Maleksameh61/Agribot/AgriBot_PCB_Cost.csv

Item | Location | Part | Qty | Unit (USD) | Total (USD) | Link | Shop (Egypt) | Product name | Unit (EGP) | Total (EGP) | Notes | International (AliExpress) | International note
1 | On the PCB | ESP32 DevKit 30-pin (CP2102) - Motion, Sensors, Audio | 3 | 5.303 | 15.91 | https://makerselectronics.com/product/esp32-development-board/ | Makers Electronics | ESP32 Development Board WIFI and Bluetooth 30-Pin with CP2102 | 280.0 | 840.0 | In stock. Measure the row gap before soldering sockets | https://www.aliexpress.com/item/1005005692090880.html | Pick the CP2102 MICRO 30Pin option. Rows must be 25.4 mm (1 in) apart to fit the footprint, many 30-pin boards are 22.86 mm
2 | On the PCB | LM2596S-ADJ buck module | 5 | 1.042 | 5.21 | https://microohm-eg.com/lm2596s-dc-step-down-3a/ | Micro Ohm | LM2596S-ADJ DC-DC Buck Converter 3A | 55.0 | 275.0 | Makers has it for 35 but sold out | https://www.aliexpress.com/item/10000000656280.html | Adjustable one with the trimmer, not fixed 5V. SIM800L needs 4.0V
3 | On the PCB | DRV8825 stepper driver | 1 | 1.515 | 1.52 | https://microohm-eg.com/drv8825-stepper-motor-driver-heatsink/ | Micro Ohm | DRV8825 Stepper Motor Driver with Aluminum Heat Sink | 80.0 | 80.0 | Only local source found | https://www.aliexpress.com/item/32852539255.html | Pololu-style 16-pin, with heatsink
4 | On the PCB | SIM800L GSM module + antenna | 1 | 5.492 | 5.49 | https://microohm-eg.com/sim800l-gprs-gsm-module-core-board-quad-band-ttl-serial-port-with-the-antenna/ | Micro Ohm | SIM800L GPRS GSM Module Core Board Quad-band with antenna | 290.0 | 290.0 | Backup: Makers ESP-style board 400, in stock. Check pinout matches the footprint | https://www.aliexpress.com/item/1005008338130781.html | 2G only. Check your country still has a 2G network. Check pin order matches the footprint
5 | On the PCB | MAX98357A I2S amp | 2 | 2.841 | 5.68 | https://microohm-eg.com/max98357a-mod/ | Micro Ohm | MAX98357A I2S 3W Class D Amplifier Module | 150.0 | 300.0 | In stock. Makers 120 but sold out | https://www.aliexpress.com/item/1005006264217290.html | 7-pin module (with GAIN and SD)
6 | Plugs in by cable | MicroSD card module | 1 | 0.758 | 0.76 | https://makerselectronics.com/product/micro-sd-card-reader-module/ | Makers Electronics | Micro SD Card Reader Module | 40.0 | 40.0 | Check it has the level shifter (fed from 5V on this board) | https://www.aliexpress.com/i/2251801679301703.html | Must have the regulator and level shifter, it gets 5V
7 | On the PCB | TTL to RS485 auto-direction module | 1 | 1.515 | 1.52 | https://makerselectronics.com/product/hw-519-ttl-to-rs485-converter-module/ | Makers Electronics | HW-519 TTL to RS485 Converter Module | 80.0 | 80.0 | Stock not shown. Backup Micro Ohm 90 (out of stock) | https://www.aliexpress.com/item/1005010426401155.html | HW-519. Must be auto-direction, 4 logic pins, no DE/RE
8 | On the PCB | MPU6050 (GY-521) | 1 | 1.894 | 1.89 | https://makerselectronics.com/product/mpu-6050-imu-sensor-module-with-6-dof-gyroscope-accelerometer/ | Makers Electronics | MPU-6050 IMU Sensor Module 6 DOF | 100.0 | 100.0 | Backup Micro Ohm 125 | https://www.aliexpress.com/item/32340949017.html | GY-521
9 | On the PCB | BH1750 (GY-302) | 1 | 4.735 | 4.73 | https://microohm-eg.com/gy-302-bh1750-light-intensity-module/ | Micro Ohm | GY-302 BH1750 Light Intensity Module | 250.0 | 250.0 | Future has it for 120 but sold out | https://www.aliexpress.com/item/32341898423.html | GY-302
10 | Plugs in by cable | AHT20 + BMP280 module | 1 | 4.167 | 4.17 | https://microohm-eg.com/aht20bmp280-temperature-humidity-and-air-pressure-module/ | Micro Ohm | AHT20+BMP280 Temperature Humidity and Air Pressure Module | 220.0 | 220.0 | Only local combo found | https://www.aliexpress.com/item/1005007868094906.html
11 | Plugs in by cable | NEO-6M GPS + antenna | 1 | 8.333 | 8.33 | https://microohm-eg.com/ublox-gps-module-gy-neo6mv2-w-eprom-antena-u-blox/ | Micro Ohm | Ublox GPS Module GY-NEO6M with EEPROM + Antenna | 440.0 | 440.0 | Backup Makers 565, in stock | https://www.aliexpress.com/item/1005006523594418.html | Pick the one with the antenna
12 | Plugs in by cable | HC-SR04 ultrasonic | 2 | 0.758 | 1.52 | https://microohm-eg.com/hc-sr04-ultrasonic-range-finder/ | Micro Ohm | HC-SR04 Ultrasonic Range Finder Sensor | 40.0 | 80.0 |  | https://www.aliexpress.com/item/4000124226294.html
13 | On the PCB | XT60 male+female pair | 2 | 0.568 | 1.14 | https://microohm-eg.com/product/amass-nylon-xt60-connectors-male-female-pair/ | Micro Ohm | Amass Nylon XT60 Connectors Male/Female Pair | 30.0 | 60.0 | Sold out at Makers, Future and Free Electronics. Call Micro Ohm first | https://www.aliexpress.com/item/1005001279983590.html | Amass XT60H, 5 pairs. Real Amass, fakes are softer plastic and up to 20A goes through
14 | On the PCB | 5x20 fuse clips (pair) | 3 | 0.028 | 0.09 | https://makerselectronics.com/product/fuse-holder-on-pcb-for-t5x20-size-pa/ | Makers Electronics | Fuse Holder on PCB for T5x20 Size (Pair) | 1.5 | 4.5 | In stock | https://www.aliexpress.com/item/1005009806807333.html | Pick 5x20 Clip, 20pcs. 2 clips per fuse
15 | On the PCB | Fuse 20A 5x20 ceramic | 2 | 0.047 | 0.09 | https://makerselectronics.com/product/ceramic-fuse-20a-250v-size-t5x20mm/ | Makers Electronics | Ceramic Fuse 20A 250V T5x20mm | 2.5 | 5.0 | Buy 4, keep spares | https://www.aliexpress.com/item/1005005744701067.html | Pick T20AH250V. Ceramic, not glass
16 | On the PCB | Fuse 5A 5x20 slow-blow | 1 | 0.028 | 0.03 | https://makerselectronics.com/product/ceramic-fuse-5a-250v-size-t5x20mm/ | Makers Electronics | Ceramic Fuse 5A 250V T5x20mm | 1.5 | 1.5 | Out of stock everywhere online, check in person | https://www.aliexpress.com/item/1005005744701067.html | Same listing as the 20A, pick T5AH250V (slow-blow)
17 | On the PCB | MBR4045CT Schottky | 1 | 0.852 | 0.85 | https://makerselectronics.com/product/mbr4045ct-schottky-rectifier-diode-4/ | Makers Electronics | MBR4045CT Schottky Rectifier Diode 45V 40A TO-220AB | 45.0 | 45.0 | In stock | https://www.aliexpress.com/item/1005006070897032.html | TO-220
18 | On the PCB | Screw terminal 2-pin 7.5mm (motor driver power out) | 2 | 0.123 | 0.25 | https://makerselectronics.com/product/terminal-block-2-pin-kf128-7-5-2p-7/ | Makers Electronics | Terminal Block 2 Pin KF128-7.5-2P | 6.5 | 13.0 | In stock | https://www.aliexpress.com/item/1005005966834427.html | Pick KF128-7.5-2P
19 | On the PCB | Screw terminal 3-pin 5mm (soil probe power) | 1 | 0.095 | 0.09 | https://makerselectronics.com/product/kf127-5-0-3p-green-terminal-block/ | Makers Electronics | KF127-5.0-3P Green Terminal Block | 5.0 | 5.0 | 5.0 mm pitch, footprint is 5.08. Fits | https://www.aliexpress.com/item/1005005966834427.html | Same listing as the 7.5mm one, pick KF127-5.0-3P
20 | On the PCB | Screw terminal 2-pin 5mm | 1 | 0.076 | 0.08 | https://makerselectronics.com/product/kf128-5-2p-green-terminal-block-300v/ | Makers Electronics | KF128-5-2P Green Terminal Block | 4.0 | 4.0 |  | https://www.aliexpress.com/item/32988969394.html | KF128-5.0-2P
21 | On the PCB | JST XH 4-pin board header | 7 | 0.011 | 0.08 | https://makerselectronics.com/product/b4b-xh-a-jst-xh-4-pin-header-2-5mm/ | Makers Electronics | B4B-XH-A JST XH Male 4 Pin Header 2.5mm | 0.6 | 4.2 |  | https://www.aliexpress.com/item/33011012548.html | Pick 4P
22 | On the PCB | JST XH 5-pin board header | 3 | 0.014 | 0.04 | https://makerselectronics.com/product/b5b-xh-a-jst-xh-5-pin-header-2-5mm/ | Makers Electronics | B5B-XH-A JST XH Male 5 Pin Header 2.5mm | 0.75 | 2.25 |  | https://www.aliexpress.com/item/33011012548.html | Same listing as the 4-pin, pick 5P
23 | Cables | JST XH 4-pin pre-wired lead | 7 | 0.208 | 1.46 | https://makerselectronics.com/product/data-cable-jst-4-pin-2-54mm-25cm-one-side-terminal | Makers Electronics | Data Cable JST 4 Pin 25cm one side | 11.0 | 77.0 | No shop sells bare XH housings + crimps | https://www.aliexpress.com/item/1005005570841743.html | Pick 4P, female, single head (one end pre-wired)
24 | Cables | JST XH 5-pin pre-wired lead | 3 | 0.161 | 0.48 | https://microohm-eg.com/product/jst-xh-2-54-5-pin-connector-set-wire/ | Micro Ohm | JST XH 5 Pin single-end female 20cm | 8.5 | 25.5 | Stock unclear | https://www.aliexpress.com/item/1005005570841743.html | Same listing as the 4-pin, pick 5P, female, single head
25 | On the PCB | Female header strip 1x40 | 6 | 0.095 | 0.57 | https://makerselectronics.com/product/pin-headers-female-2-54mm-40-pin/ | Makers Electronics | Pin Headers Female 2.54mm 40-Pin | 5.0 | 30.0 | For ESP32s, amps, DRV8825, SIM800L, IMU, microSD, spares | https://www.aliexpress.com/item/1005001621924231.html | 1x40, 2.54 mm
26 | On the PCB | Male header strip 1x40 | 1 | 0.057 | 0.06 | https://makerselectronics.com/product/pin-headers-male-2-54mm-40-pin-strai/ | Makers Electronics | Pin Headers Male 2.54mm 40-Pin | 3.0 | 3.0 | Gain jumpers + servo headers | https://www.aliexpress.com/item/32823083016.html | 1x40, 2.54 mm
27 | On the PCB | Jumper caps | 2 | 0.095 | 0.19 | https://makerselectronics.com/product/jumper-shunt-2-pin-2-54mm-5-pcs/ | Makers Electronics | Jumper Shunt 2 Pin 2.54mm (5 pcs) | 5.0 | 10.0 | ESTIMATE, price not listed online (a few EGP per pack of 5) | https://www.aliexpress.com/item/1005008466863615.html | 2.54 mm
28 | On the PCB | LED 5mm | 5 | 0.009 | 0.05 | https://free-electronic.com/product/led-red-color-5mm/ | Free Electronics | LED Red Color (5mm) | 0.5 | 2.5 | One per power rail | https://www.aliexpress.com/item/4000412956904.html | Pick Red-Red
29 | On the PCB | Resistors 1/4W (220 x5, 1k x3, 2k x2, 3.3k, 4.7k x2, 10k x5, 22k x2, 100k x2) | 22 | 0.004 | 0.08 | https://free-electronic.com/product/resistor-100-kohm-1-4w/ | Free Electronics | Resistor 1/4W | 0.2 | 4.4 | Per piece | https://www.aliexpress.com/item/1005002364388450.html | Assortment kit covers all the values
30 | On the PCB | Ceramic capacitor 100nF 50V | 18 | 0.009 | 0.17 | https://free-electronic.com/product/ceramic-capacitor-100nf-50v-104/ | Free Electronics | Ceramic Capacitor (100nF, 50V) (104) | 0.5 | 9.0 |  | https://www.aliexpress.com/item/32429917283.html | Pick 100nF (104)
31 | On the PCB | Electrolytic 1000uF 16V | 4 | 0.033 | 0.13 | https://makerselectronics.com/product/chong-aluminum-electrolytic-capacitor-1000uf-16v-8x16mm/ | Makers Electronics | Chong 1000uF 16V 8x16mm | 1.75 | 7.0 |  | https://www.aliexpress.com/item/1005011811368397.html | Pick 16V 1000UF 40PCS
32 | On the PCB | Electrolytic 1000uF 35V | 1 | 0.066 | 0.07 | https://makerselectronics.com/product/capacitor-1000uf-35v/ | Makers Electronics | Capacitor 1000uF 35V | 3.5 | 3.5 | On the 12V rail | https://www.aliexpress.com/item/1005011811368397.html | Same listing as the 16V ones, pick 35V 1000UF 10PCS. 35V or more, it's on the 12V rail
33 | On the PCB | Electrolytic 470uF 16V | 2 | 0.033 | 0.07 | https://makerselectronics.com/product/capacitor-470uf-16v-6x12mm/ | Makers Electronics | Capacitor 470uF 16V 6x12mm | 1.75 | 3.5 |  | https://www.aliexpress.com/item/1005011811368397.html | Same listing, pick 16V 470UF 40PCS
34 | On the PCB | Electrolytic 100uF 16V | 3 | 0.019 | 0.06 | https://microohm-eg.com/product/electrolytic-capacitor-100uf-16v/ | Micro Ohm | Electrolytic Capacitor 100uF 16V | 1.0 | 3.0 | Makers 0.75 but sold out | https://www.aliexpress.com/item/1005011811368397.html | Same listing, pick 16V 100UF 40PCS
35 | On the PCB | Electrolytic 10uF 16V | 1 | 0.013 | 0.01 | https://microohm-eg.com/product/electrolytic-capacitor-1000uf-16v/ | Micro Ohm | Electrolytic Capacitor 10uF 16V | 0.7 | 0.7 |  | https://www.aliexpress.com/item/1005011811368397.html | Same listing, pick 16V 10UF 40PCS
36 | PCB fabrication | PCB fabrication, 2-layer 260x150 mm 2 oz HASL, qty 5 (JLCPCB) | 5 | 13.76 | 68.80 | https://jlcpcb.com/quote | JLCPCB |  |  |  | JLCPCB web quote, Nov 3 2026: 2-layer, 260x150 mm, 2 oz outer copper, qty 5. Engineering fee $4 + board $18.80 + 2 oz copper $46 |  | Same as Link, JLCPCB already ships worldwide
37 | Shipping | Shipping: JLCPCB to Egypt | 1 | 32.0 | 32.00 | https://jlcpcb.com/help/article/do-you-ship-boards-to-my-country | JLCPCB |  |  |  | JLCPCB quote page shipping estimate: UPS Express Saver (DDP), 2-4 business days, 0.88 kg
38 | Shipping | Shipping: Makers Electronics delivery | 1 | 0.0 | 0.0 | https://makerselectronics.com/ | Makers Electronics |  | 0 | 0 | Free above 1000 EGP, this order is above that
39 | Shipping | Shipping: Micro Ohm delivery (Cairo) | 1 | 1.89 | 1.89 | https://microohm-eg.com/ | Micro Ohm |  | 100 | 100 | ESTIMATE, confirm at checkout
40 | Shipping | Shipping: Free Electronics | 1 | 0.95 | 0.95 | https://free-electronic.com/ | Free Electronics |  | 50 | 50 | ESTIMATE, or pick up
TOTAL |  | TOTAL - bare PCB |  |  | 166.51 |  |  |  |  |  | Bare PCB build: the board plus the modules and sensors that plug into it, with PCB fabrication and shipping. USD at 52.8 EGP (NBE sell rate, Oct 13 2026). Off-board parts (motor drivers, motors, batteries, chassis, speakers, ESP32-CAM, touch screen, soil probe) are not in this file. PCB price is a JLCPCB web quote from Nov 3 2026
