Maleksameh61/Agribot/BOM/AgriBot_Entire_Project_Cost.xlsx

AgriBot - what the whole thing costs
Every part I need to build the rover, sorted by where it goes. Prices are what the shops list right now, in EGP unless it says USD.
EGP per 1 USD: | 52.8 | NBE sell rate on Oct 13 2026 (same one as AgriBot_PCB_Cost.csv). Change it and all the USD numbers update.
Legend: | Blue = prices I typed in. Black = formulas. Yellow = still missing a price or a link.
Summary
 | Where it goes |  |  |  | EGP | USD
 | On the PCB |  |  |  | 2436.05 | $46.14
 | Off the PCB - plugs in by cable |  |  |  | 780 | $14.77
 | Cables and connector leads |  |  |  | 102.5 | $1.94
 | PCB fabrication and shipping |  |  |  | 5472.24 | $103.64
 | Off the PCB - not on the board |  |  |  | 20970 | $397.16
 | Entire project |  |  |  | 29760.79 | $563.65
 | Just the board (what AgriBot_PCB_Cost.csv has) |  |  |  | 8790.79 | $166.49
# | Part | Qty | Unit price (EGP) | Unit price (USD) | Total (EGP) | Total (USD) | In PCB cost? | Shop | Link | Notes | International (AliExpress) | International note
On the PCB
1 | ESP32 DevKit 30-pin (CP2102) - Motion, Sensors, Audio | 3 | 280.00 | $5.30 | 840 | $15.91 | Yes | Makers Electronics | https://makerselectronics.com/product/esp32-development-board/ | In stock. Measure the row gap before I solder the sockets | https://www.aliexpress.com/item/1005005692090880.html | Pick the CP2102 MICRO 30Pin option. Rows must be 25.4 mm (1 in) apart to fit the footprint, many 30-pin boards are 22.86 mm
2 | LM2596S-ADJ buck module | 5 | 55.00 | $1.04 | 275 | $5.21 | Yes | Micro Ohm | https://microohm-eg.com/lm2596s-dc-step-down-3a/ | Makers has it for 35 but it's sold out | https://www.aliexpress.com/item/10000000656280.html | Adjustable one with the trimmer, not fixed 5V. SIM800L needs 4.0V
3 | DRV8825 stepper driver | 1 | 80.00 | $1.52 | 80 | $1.52 | Yes | Micro Ohm | https://microohm-eg.com/drv8825-stepper-motor-driver-heatsink/ | Only place in Egypt I found it | https://www.aliexpress.com/item/32852539255.html | Pololu-style 16-pin, with heatsink
4 | SIM800L GSM module + antenna | 1 | 290.00 | $5.49 | 290 | $5.49 | Yes | Micro Ohm | https://microohm-eg.com/sim800l-gprs-gsm-module-core-board-quad-band-ttl-serial-port-with-the-antenna/ | Backup is the Makers board for 400 (in stock). Check the pinout matches my footprint | https://www.aliexpress.com/item/1005008338130781.html | 2G only. Check your country still has a 2G network. Check pin order matches the footprint
5 | MAX98357A I2S amp | 2 | 150.00 | $2.84 | 300 | $5.68 | Yes | Micro Ohm | https://microohm-eg.com/max98357a-mod/ | In stock. Makers has it for 120 but sold out | https://www.aliexpress.com/item/1005006264217290.html | 7-pin module (with GAIN and SD)
6 | TTL to RS485 auto-direction module | 1 | 80.00 | $1.52 | 80 | $1.52 | Yes | Makers Electronics | https://makerselectronics.com/product/hw-519-ttl-to-rs485-converter-module/ | Doesn't say if it's in stock. Backup Micro Ohm 90 (sold out) | https://www.aliexpress.com/item/1005010426401155.html | HW-519. Must be auto-direction, 4 logic pins, no DE/RE
7 | MPU6050 (GY-521) | 1 | 100.00 | $1.89 | 100 | $1.89 | Yes | Makers Electronics | https://makerselectronics.com/product/mpu-6050-imu-sensor-module-with-6-dof-gyroscope-accelerometer/ | Backup Micro Ohm 125 | https://www.aliexpress.com/item/32340949017.html | GY-521
8 | BH1750 (GY-302) | 1 | 250.00 | $4.73 | 250 | $4.73 | Yes | Micro Ohm | https://microohm-eg.com/gy-302-bh1750-light-intensity-module/ | Future has it for 120 but sold out | https://www.aliexpress.com/item/32341898423.html | GY-302
9 | XT60 male+female pair | 2 | 30.00 | $0.57 | 60 | $1.14 | Yes | Micro Ohm | https://microohm-eg.com/product/amass-nylon-xt60-connectors-male-female-pair/ | Sold out at Makers, Future and Free Electronics, so call Micro Ohm first | https://www.aliexpress.com/item/1005001279983590.html | Amass XT60H, 5 pairs. Real Amass, fakes are softer plastic and up to 20A goes through
10 | 5x20 fuse clips (pair) | 3 | 1.50 | $0.03 | 4.5 | $0.09 | Yes | Makers Electronics | https://makerselectronics.com/product/fuse-holder-on-pcb-for-t5x20-size-pa/ | In stock | https://www.aliexpress.com/item/1005009806807333.html | Pick 5x20 Clip, 20pcs. 2 clips per fuse
11 | Fuse 20A 5x20 ceramic | 2 | 2.50 | $0.05 | 5 | $0.09 | Yes | Makers Electronics | https://makerselectronics.com/product/ceramic-fuse-20a-250v-size-t5x20mm/ | Getting 4 so I have spares | https://www.aliexpress.com/item/1005005744701067.html | Pick T20AH250V. Ceramic, not glass
12 | Fuse 5A 5x20 slow-blow | 1 | 1.50 | $0.03 | 1.5 | $0.03 | Yes | Makers Electronics | https://makerselectronics.com/product/ceramic-fuse-5a-250v-size-t5x20mm/ | Sold out on every site, have to check in person | https://www.aliexpress.com/item/1005005744701067.html | Same listing as the 20A, pick T5AH250V (slow-blow)
13 | MBR4045CT Schottky | 1 | 45.00 | $0.85 | 45 | $0.85 | Yes | Makers Electronics | https://makerselectronics.com/product/mbr4045ct-schottky-rectifier-diode-4/ | In stock | https://www.aliexpress.com/item/1005006070897032.html | TO-220
14 | Screw terminal 2-pin 7.5mm (motor driver power out) | 2 | 6.50 | $0.12 | 13 | $0.25 | Yes | Makers Electronics | https://makerselectronics.com/product/terminal-block-2-pin-kf128-7-5-2p-7/ | In stock | https://www.aliexpress.com/item/1005005966834427.html | Pick KF128-7.5-2P
15 | Screw terminal 3-pin 5mm (soil probe power) | 1 | 5.00 | $0.09 | 5 | $0.09 | Yes | Makers Electronics | https://makerselectronics.com/product/kf127-5-0-3p-green-terminal-block/ | 5.0 mm pitch and my footprint is 5.08, it still fits | https://www.aliexpress.com/item/1005005966834427.html | Same listing as the 7.5mm one, pick KF127-5.0-3P
16 | Screw terminal 2-pin 5mm | 1 | 4.00 | $0.08 | 4 | $0.08 | Yes | Makers Electronics | https://makerselectronics.com/product/kf128-5-2p-green-terminal-block-300v/ |  | https://www.aliexpress.com/item/32988969394.html | KF128-5.0-2P
17 | JST XH 4-pin board header | 7 | 0.60 | $0.01 | 4.2 | $0.08 | Yes | Makers Electronics | https://makerselectronics.com/product/b4b-xh-a-jst-xh-4-pin-header-2-5mm/ |  | https://www.aliexpress.com/item/33011012548.html | Pick 4P
18 | JST XH 5-pin board header | 3 | 0.75 | $0.01 | 2.25 | $0.04 | Yes | Makers Electronics | https://makerselectronics.com/product/b5b-xh-a-jst-xh-5-pin-header-2-5mm/ |  | https://www.aliexpress.com/item/33011012548.html | Same listing as the 4-pin, pick 5P
19 | Female header strip 1x40 | 6 | 5.00 | $0.09 | 30 | $0.57 | Yes | Makers Electronics | https://makerselectronics.com/product/pin-headers-female-2-54mm-40-pin/ | For the ESP32s, amps, DRV8825, SIM800L, IMU, microSD and spares | https://www.aliexpress.com/item/1005001621924231.html | 1x40, 2.54 mm
20 | Male header strip 1x40 | 1 | 3.00 | $0.06 | 3 | $0.06 | Yes | Makers Electronics | https://makerselectronics.com/product/pin-headers-male-2-54mm-40-pin-strai/ | Gain jumpers and servo headers | https://www.aliexpress.com/item/32823083016.html | 1x40, 2.54 mm
21 | Jumper caps | 2 | 5.00 | $0.09 | 10 | $0.19 | Yes | Makers Electronics | https://makerselectronics.com/product/jumper-shunt-2-pin-2-54mm-5-pcs/ | Guess, no price online (should be a few EGP for 5) | https://www.aliexpress.com/item/1005008466863615.html | 2.54 mm
22 | LED 5mm | 5 | 0.50 | $0.01 | 2.5 | $0.05 | Yes | Free Electronics | https://free-electronic.com/product/led-red-color-5mm/ | One per power rail | https://www.aliexpress.com/item/4000412956904.html | Pick Red-Red
23 | Resistors 1/4W (220 x5, 1k x3, 2k x2, 3.3k, 4.7k x2, 10k x5, 22k x2, 100k x2) | 22 | 0.20 | $0.003787878788 | 4.4 | $0.08 | Yes | Free Electronics | https://free-electronic.com/product/resistor-100-kohm-1-4w/ | Price is per resistor | https://www.aliexpress.com/item/1005002364388450.html | Assortment kit covers all the values
24 | Ceramic capacitor 100nF 50V | 18 | 0.50 | $0.01 | 9 | $0.17 | Yes | Free Electronics | https://free-electronic.com/product/ceramic-capacitor-100nf-50v-104/ |  | https://www.aliexpress.com/item/32429917283.html | Pick 100nF (104)
25 | Electrolytic 1000uF 16V | 4 | 1.75 | $0.03 | 7 | $0.13 | Yes | Makers Electronics | https://makerselectronics.com/product/chong-aluminum-electrolytic-capacitor-1000uf-16v-8x16mm/ |  | https://www.aliexpress.com/item/1005011811368397.html | Pick 16V 1000UF 40PCS
26 | Electrolytic 1000uF 35V | 1 | 3.50 | $0.07 | 3.5 | $0.07 | Yes | Makers Electronics | https://makerselectronics.com/product/capacitor-1000uf-35v/ | On the 12V rail | https://www.aliexpress.com/item/1005011811368397.html | Same listing as the 16V ones, pick 35V 1000UF 10PCS. 35V or more, it's on the 12V rail
27 | Electrolytic 470uF 16V | 2 | 1.75 | $0.03 | 3.5 | $0.07 | Yes | Makers Electronics | https://makerselectronics.com/product/capacitor-470uf-16v-6x12mm/ |  | https://www.aliexpress.com/item/1005011811368397.html | Same listing, pick 16V 470UF 40PCS
28 | Electrolytic 100uF 16V | 3 | 1.00 | $0.02 | 3 | $0.06 | Yes | Micro Ohm | https://microohm-eg.com/product/electrolytic-capacitor-100uf-16v/ | Makers has it for 0.75 but sold out | https://www.aliexpress.com/item/1005011811368397.html | Same listing, pick 16V 100UF 40PCS
29 | Electrolytic 10uF 16V | 1 | 0.70 | $0.01 | 0.7 | $0.01 | Yes | Micro Ohm | https://microohm-eg.com/product/electrolytic-capacitor-1000uf-16v/ |  | https://www.aliexpress.com/item/1005011811368397.html | Same listing, pick 16V 10UF 40PCS
 | Subtotal |  |  |  | 2436.05 | $46.14
Off the PCB - plugs in by cable
30 | MicroSD card module | 1 | 40.00 | $0.76 | 40 | $0.76 | Yes | Makers Electronics | https://makerselectronics.com/product/micro-sd-card-reader-module/ | Make sure it has the level shifter, it gets 5V on my board | https://www.aliexpress.com/i/2251801679301703.html | Must have the regulator and level shifter, it gets 5V
31 | AHT20 + BMP280 module | 1 | 220.00 | $4.17 | 220 | $4.17 | Yes | Micro Ohm | https://microohm-eg.com/aht20bmp280-temperature-humidity-and-air-pressure-module/ | Only AHT20 + BMP280 combo I found here | https://www.aliexpress.com/item/1005007868094906.html
32 | NEO-6M GPS + antenna | 1 | 440.00 | $8.33 | 440 | $8.33 | Yes | Micro Ohm | https://microohm-eg.com/ublox-gps-module-gy-neo6mv2-w-eprom-antena-u-blox/ | Backup Makers 565, in stock | https://www.aliexpress.com/item/1005006523594418.html | Pick the one with the antenna
33 | HC-SR04 ultrasonic | 2 | 40.00 | $0.76 | 80 | $1.52 | Yes | Micro Ohm | https://microohm-eg.com/hc-sr04-ultrasonic-range-finder/ |  | https://www.aliexpress.com/item/4000124226294.html
 | Subtotal |  |  |  | 780 | $14.77
Cables and connector leads
34 | JST XH 4-pin pre-wired lead | 7 | 11.00 | $0.21 | 77 | $1.46 | Yes | Makers Electronics | https://makerselectronics.com/product/data-cable-jst-4-pin-2-54mm-25cm-one-side-terminal | Nobody here sells the bare XH housings and crimps, so pre-wired it is | https://www.aliexpress.com/item/1005005570841743.html | Pick 4P, female, single head (one end pre-wired)
35 | JST XH 5-pin pre-wired lead | 3 | 8.50 | $0.16 | 25.5 | $0.48 | Yes | Micro Ohm | https://microohm-eg.com/product/jst-xh-2-54-5-pin-connector-set-wire/ | Not sure if it's in stock | https://www.aliexpress.com/item/1005005570841743.html | Same listing as the 4-pin, pick 5P, female, single head
 | Subtotal |  |  |  | 102.5 | $1.94
PCB (JLCPCB) and shipping
36 | PCB fabrication, 2-layer 260x150 mm 2 oz HASL, qty 5 (JLCPCB) | 5 |  | $13.76 | 3632.64 | $68.80 | Yes | JLCPCB | https://jlcpcb.com/quote | JLCPCB quote from Nov 3 2026, 2-layer, 260x150 mm, 2 oz, 5 boards. $4 engineering fee + $18.80 boards + $46 for the 2 oz copper |  | Same as Link, JLCPCB already ships worldwide
37 | Shipping: JLCPCB to Egypt | 1 |  | $32.00 | 1689.6 | $32.00 | Yes | JLCPCB | https://jlcpcb.com/help/article/do-you-ship-boards-to-my-country | Shipping JLCPCB showed me: UPS Express Saver (DDP), 2-4 business days, 0.88 kg
38 | Shipping: Makers Electronics delivery | 1 | 0.00 | $0.00 | 0 | $0.00 | Yes | Makers Electronics | https://makerselectronics.com/ | Free delivery over 1000 EGP and this order is way over
39 | Shipping: Micro Ohm delivery (Cairo) | 1 | 100.00 | $1.89 | 100 | $1.89 | Yes | Micro Ohm | https://microohm-eg.com/ | Guess, will see at checkout
40 | Shipping: Free Electronics | 1 | 50.00 | $0.95 | 50 | $0.95 | Yes | Free Electronics | https://free-electronic.com/ | Guess, or I just go pick it up
 | Subtotal |  |  |  | 5472.24 | $103.64
Not on the board (motors, drivers, power, chassis...)
41 | Cytron MDD10A dual-channel motor driver | 2 | 1400.00 | $26.52 | 2800 | $53.03 | No | Future Electronics | https://store.fut-electronics.com/products/dual-channel-dc-motor-driver-10a-each | Has a price but says UNAVAILABLE, need to check stock or find it somewhere else | https://www.aliexpress.com/item/1005008884360350.html | Make sure it's a real Cytron board, Rev 2.0 takes up to 30V
42 | 5840-31ZY worm gearmotor 12V 60RPM D-shaft 8mm with bracket | 4 | 1200.00 | $22.73 | 4800 | $90.91 | No | Makers Electronics | https://makerselectronics.com/product/5840-31zy-high-torque-worm-dc-gear-motor-12v-60rpm-d-shaft-8mm-with-bracket/ | In stock. The most expensive thing on the whole rover | https://www.aliexpress.com/item/1005006213308752.html | No 60 RPM on AliExpress. Closest is 50 RPM, pick 12V and Motor and Bracket. Rover will be about 17% slower. Check it is the 8 mm D-shaft
43 | ESP32-2432S028R 2.8in touch display (CYD) | 1 | 1200.00 | $22.73 | 1200 | $22.73 | No | Makers Electronics | https://makerselectronics.com/product/esp32-module-with-2-8-tft-touch-screen-display-wifi-bluetooth/ | In stock | https://www.aliexpress.com/item/1005007401669955.html | The R one, resistive touch
44 | Speaker 8 ohm 10W 125x60mm | 2 | 60.00 | $1.14 | 120 | $2.27 | No | Makers Electronics | https://makerselectronics.com/product/speaker-8-ohm-10w-125x60mm/ | In stock | https://www.aliexpress.com/item/1005008358359319.html | SOTAMIA pair, pick 8 Ohm 10W Speaker. It's 120x50 mm, not 125x60, so check it fits the mount
45 | 12V 12Ah sealed lead-acid battery (UniTex) | 2 | 1470.00 | $27.84 | 2940 | $55.68 | No | Noon (via Pricena) | https://eg.pricena.com/ar/product/battery-12v-12a-price-in-Egypt-26492399 | Cheapest one I found. Listing says "12V 12A", so make sure it's actually 12Ah lead-acid before buying. I might already have packs at home | https://www.aliexpress.com/item/1005009975315186.html | Pick 12V 12Ah. About 4 kg each, check shipping before ordering
46 | NEMA 17 stepper 17HS3401 | 1 | 350.00 | $6.63 | 350 | $6.63 | No | Makers Electronics | https://makerselectronics.com/product/nema-17-stepper-motor-17hs3401/ | Only 0.28 Nm holding torque, the probe push math assumed ~0.4 Nm so it'll push less | https://www.aliexpress.com/item/1005009297521284.html | 17HS3401
47 | ZTS-3002 RS485 soil probe (T/moisture/pH/EC/NPK) | 1 | 3750.00 | $71.02 | 3750 | $71.02 | No | Makers Electronics | https://makerselectronics.com/product/zts-3002-tr-ecthnpkph-n01-soil-multi-parameter-sensor-temperature-moisture-ph-ec-nitrogen-phosphorus-potassium-rs485-type/ | Second most expensive thing | https://www.aliexpress.com/item/1005005697940574.html | Pick TH-EC-PH-NPK, RS485 / Modbus (N01), not 4-20mA or 0-5V. Check the register list matches the Sensors firmware
48 | ESP32-CAM (OV2640) | 2 | 495.00 | $9.38 | 990 | $18.75 | No | Makers Electronics | https://makerselectronics.com/ar/product/esp32-cam-esp32-s-wifibluetooth-with-ov2640-camera-module/ | In stock. Getting 2, one is a spare | https://www.aliexpress.com/item/1005009401125349.html | Pick ESP32-CAM-MB (camera board plus the MB base), OV2640 camera
49 | ESP32-CAM-MB micro-USB programmer base | 2 | 80.00 | $1.52 | 160 | $3.03 | No | Makers Electronics | https://makerselectronics.com/product/esp32-cam-mb-micro-usb-download-module-for-esp32-cam | In stock (another listing has it for 75) | https://www.aliexpress.com/item/1005009401125349.html | Same listing as the ESP32-CAM. Downloade Board is the MB base alone if you only need the spare base
50 | Micro metal-gear servo 1.8 kg.cm (pan/tilt) | 2 | 330.00 | $6.25 | 660 | $12.50 | No | Future Electronics | https://store.fut-electronics.com/products/micro-metal-gear-servo-1-8-kg-cm | Stock not shown. Make sure it's 180 degree and not continuous. Makers MG90S was sold out | https://www.aliexpress.com/item/1005012590262403.html | MG90S, pick a 180deg pack, not 360 continuous
51 | RS003CS 120x60mm wheel | 4 | 200.00 | $3.79 | 800 | $15.15 | No | Makers Electronics | https://makerselectronics.com/product-category/motors-drivers-wheels/wheels/ | About 400 EGP per 2 wheels from what I remember. Makers lists 130x59 mm ones at 390-400 and doesn't say if that's per wheel or per pair. If it's per wheel, 4 is about 1,600 | https://www.aliexpress.com/item/1005013362289565.html | 125 mm, pick 125mm wheel D8mm
52 | 9 mm plywood for the chassis (CNC cut) | 1 | 1850.00 | $35.04 | 1850 | $35.04 | No | Local wood shop | No link, bought it in person | About 1850 EGP. Got the sheets from a wood shop and CNC cut them |  | Not sold in sheet sizes on AliExpress, get it from a local wood shop
53 | M3 / M4 / M5 screw, nut and washer assortment box | 1 | 310.00 | $5.87 | 310 | $5.87 | No | Amazon.eg | https://www.amazon.eg/-/en/Galvanized-Assortment-Assorted-Industrial-Electronic/dp/B092Z36MMR | Mixed box, 12 sizes of M3/M4/M5 screws with nuts and washers. Price moves between about 275 and 325 EGP | https://www.aliexpress.com/item/1005006140198276.html | Pick M3M4M5 (345Pcs). Countersunk heads, 304 stainless, with nuts and washers
54 | SanDisk Ultra 32GB microSD | 1 | 240.00 | $4.55 | 240 | $4.55 | No | Makers Electronics | https://makerselectronics.com/product/sandisk-ultra-32gb-memory-card-120mb | 240 EGP, stock not shown. I thought it was 150. kaza.com.eg has it for 154 but sold out | https://www.aliexpress.com/item/1005010037171891.html | Pick 32GB. Not SanDisk's official store but 8k+ sold. Test the card with H2testw
 | Subtotal |  |  |  | 20970 | $397.16
 | WHOLE ROVER (rows that have a price) |  |  |  | 29760.79 | $563.65 |  |  |  | Yellow rows aren't counted yet
