Maleksameh61/Agribot/CAD/agribot-full-assembly.step

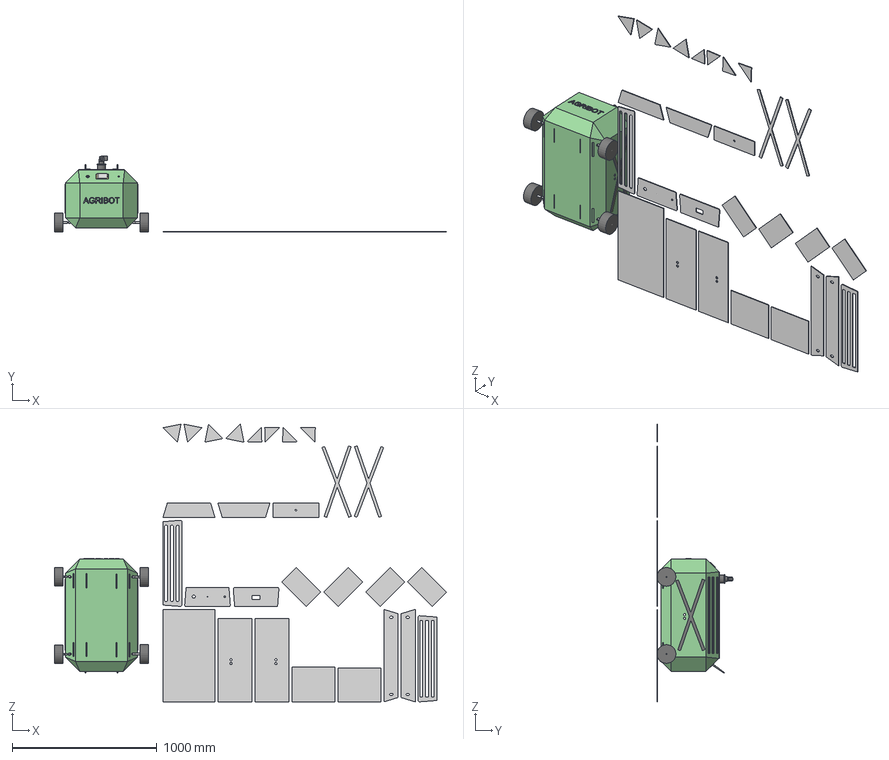
[picture p9: CAD file, 2026-11-03]
CAD/agribot-full-assembly.step
2711.7 x 529.0 x 1921.5 mm
LaserFlatLayout
10mm connector x 3
Spkr Connector
switch x 2
Micro SD Card
ESP32 WROOM
Micro USB 5 Pins, Right Angle SMT v1
LDR 21
BATTERY CAPACITY VOLTAGE
