Maleksameh61/Agribot/production/printables/pan-tilt-tilt-plate.step

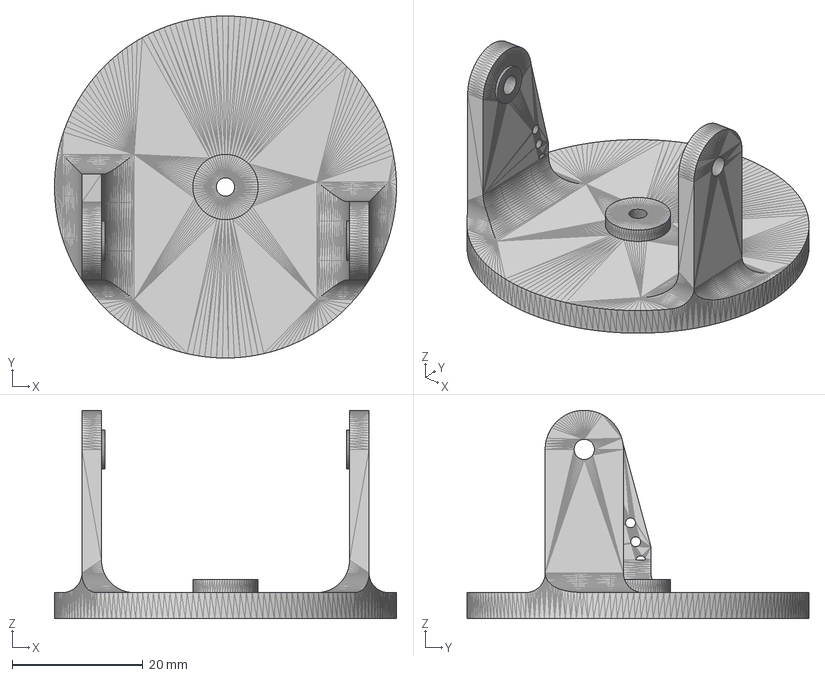
[picture p10: CAD file, 2026-11-06]
production/printables/pan-tilt-tilt-plate.step
52.4 x 52.4 x 31.9 mm
