Maleksameh61/Agribot/production/printables/pan-tilt-cam-back-cover.step

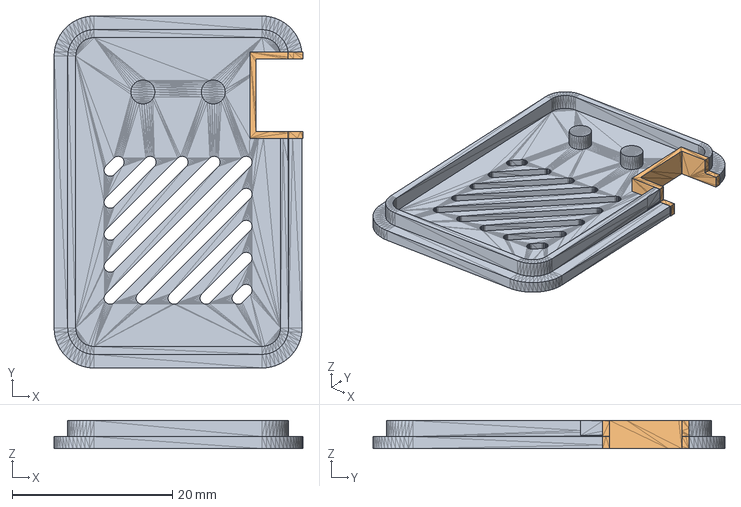
[picture p11: CAD file, 2026-11-06]
production/printables/pan-tilt-cam-back-cover.step
31.1 x 44.0 x 3.53 mm
