Maleksameh61/Agribot/production/printables/pan-tilt-yaw-base.step

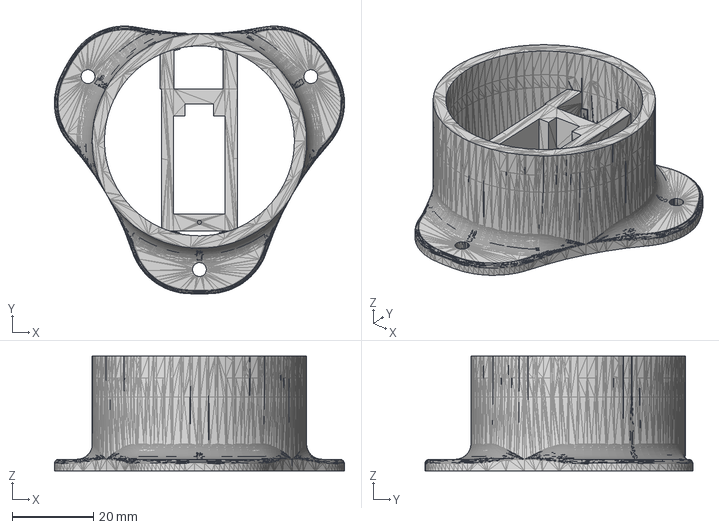
[picture p12: CAD file, 2026-11-06]
production/printables/pan-tilt-yaw-base.step
71.2 x 65.8 x 28.2 mm
