Maleksameh61/Agribot/production/printables/pan-tilt-cam-case-with-tilt-support.step

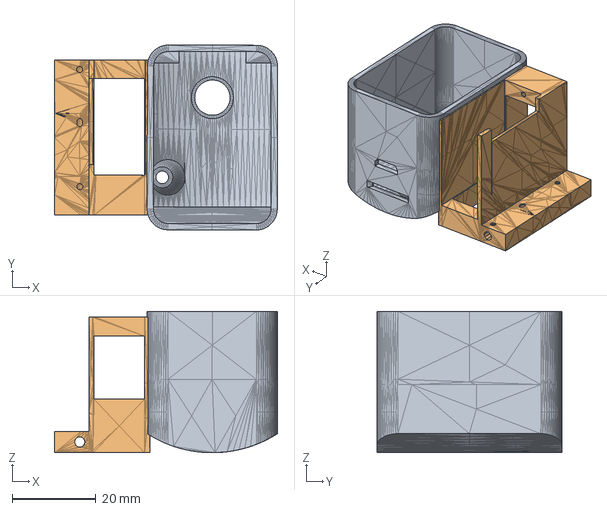
[picture p13: CAD file, 2026-11-06]
production/printables/pan-tilt-cam-case-with-tilt-support.step
53.1 x 44.0 x 33.7 mm
