Maleksameh61/Agribot/production/printables/motor-mount-2.step

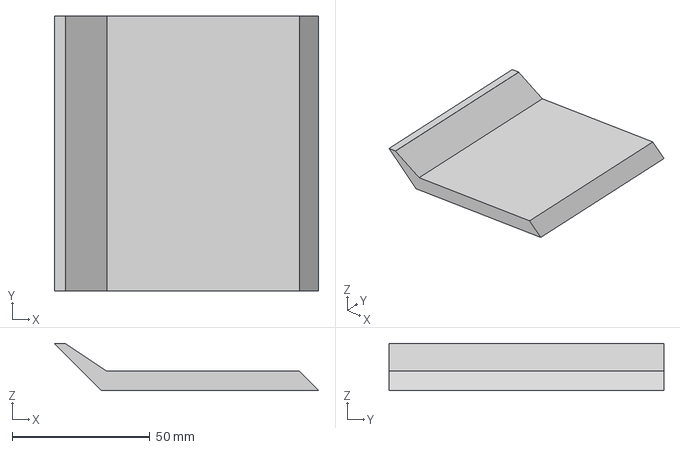
[picture p14: CAD file, 2026-11-06]
production/printables/motor-mount-2.step
96.2 x 100.0 x 17.1 mm
