Maleksameh61/Agribot/(list of files, cad)

Other CAD files:
CAD/agribot-pcb.step
production/printables/motor-mount-1.step
production/printables/motor-mount-4.step
production/printables/motor-mount-3.step
