Maleksameh61/Agribot/production/printables/README.md

# Printables

Everything here is STEP. Open it in Fusion or drop it straight into your slicer.

## Motor mounts

`motor-mount-1.step` to `motor-mount-4.step` are the plates the four worm gearmotors sit on. They're the same part, so you can just print one file four times. They come straight out of my Fusion file (Body101 to Body104).

## Camera pan/tilt

I didn't design this one. It's werz 99's [ESP32 Cam Pan and Tilt Camera](https://www.printables.com/model/148269) from Printables, which is itself a remix of Electronlibre's MG90S tilt/yaw mount on Thingiverse. It fits the ESP32-CAM and two MG90S servos, which is exactly what AgriBot uses, so I didn't see a reason to redraw it.

- `pan-tilt-yaw-base.step`: the base, holds the pan servo
- `pan-tilt-tilt-plate.step`: the tilt plate
- `pan-tilt-cam-case-with-tilt-support.step`: the camera case with the tilt arm
- `pan-tilt-cam-back-cover.step`: the back cover

The original settings were PETG at 0.3 mm layers, about 3 h 15 min and 55 g for all four. I converted the STLs to STEP, so they're made of triangles, not clean CAD faces. They print the same, but don't expect to edit them nicely.

These four keep the original license, CC BY-NC-SA 4.0, so no selling them, and credit werz 99 if you share them.
