Maleksameh61/Agribot/production/schematic.pdf

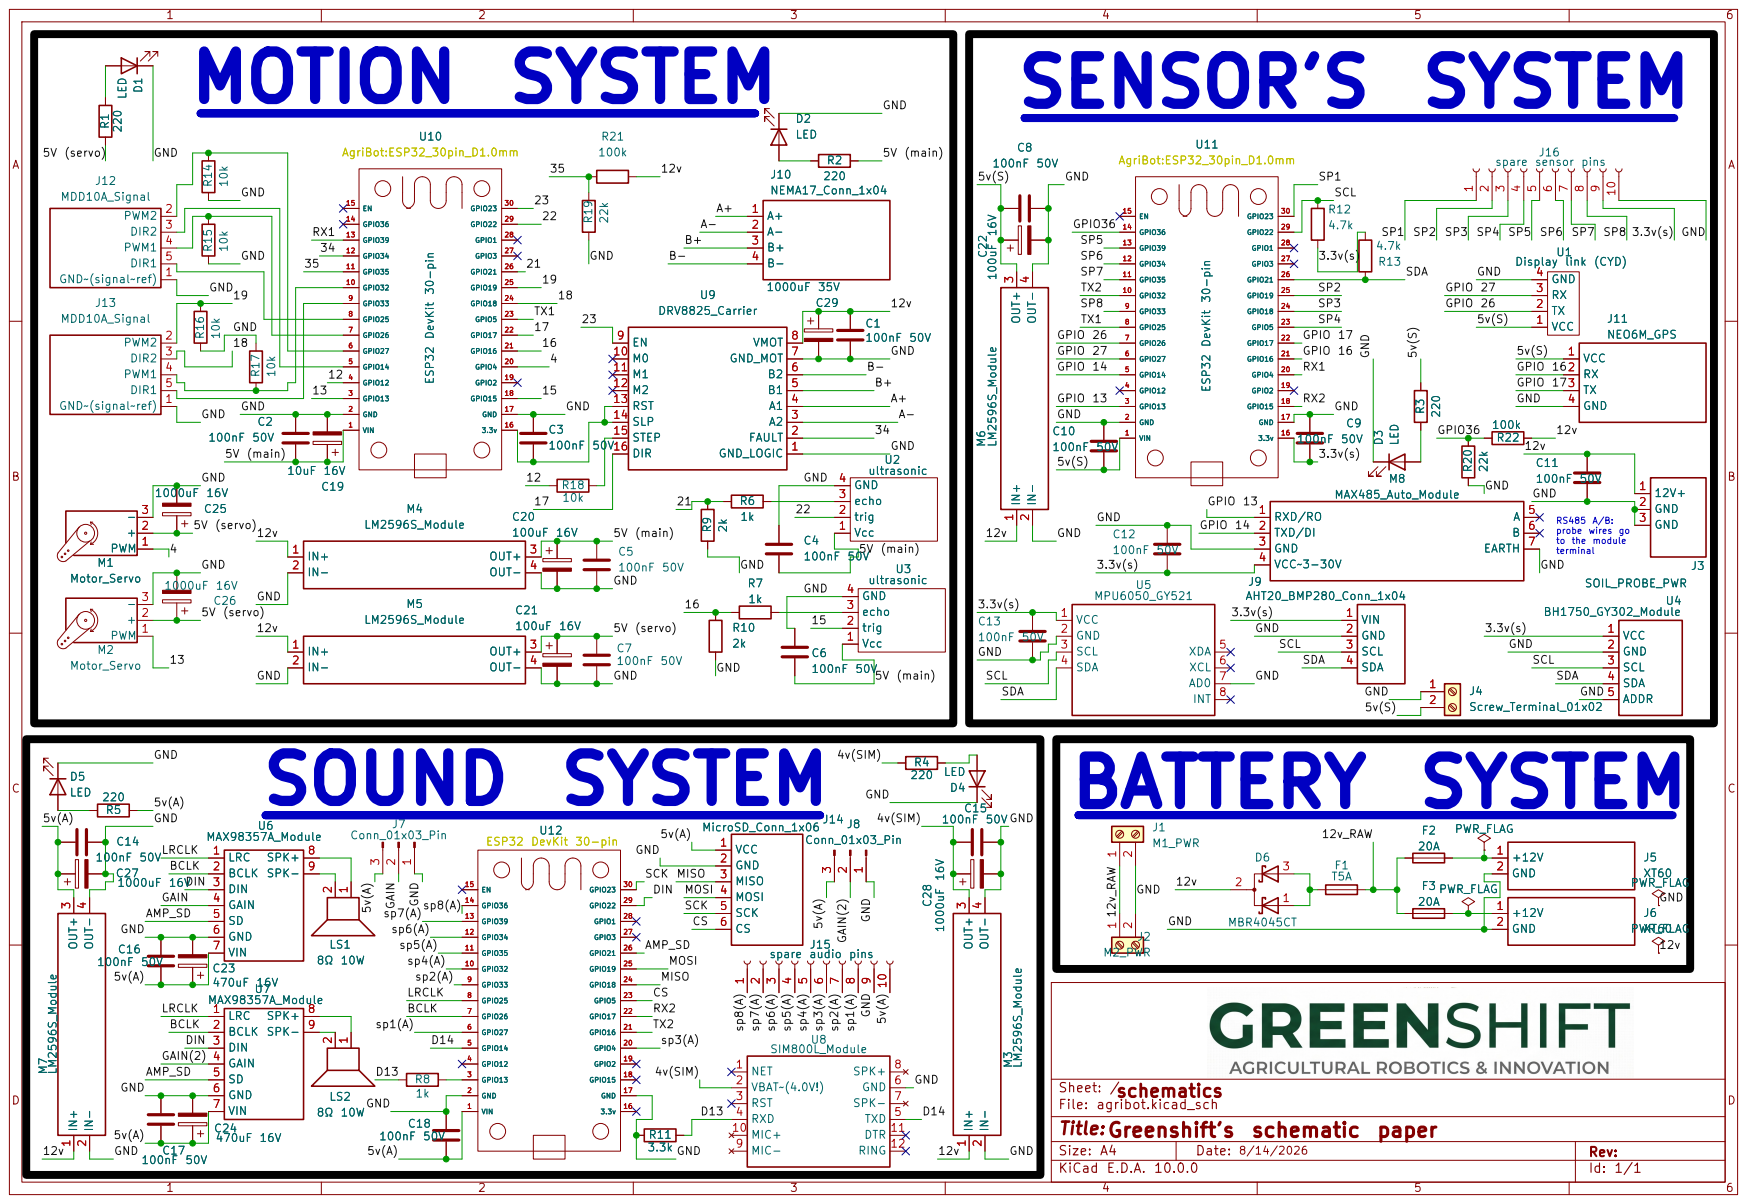
[picture p15: page 1]

U1 Display link (CYD) VCC 1
