Maleksameh61/Agribot/PCB/agribot.kicad_pcb

## KiCad design PCB/agribot.kicad_pcb (2026-10-20)

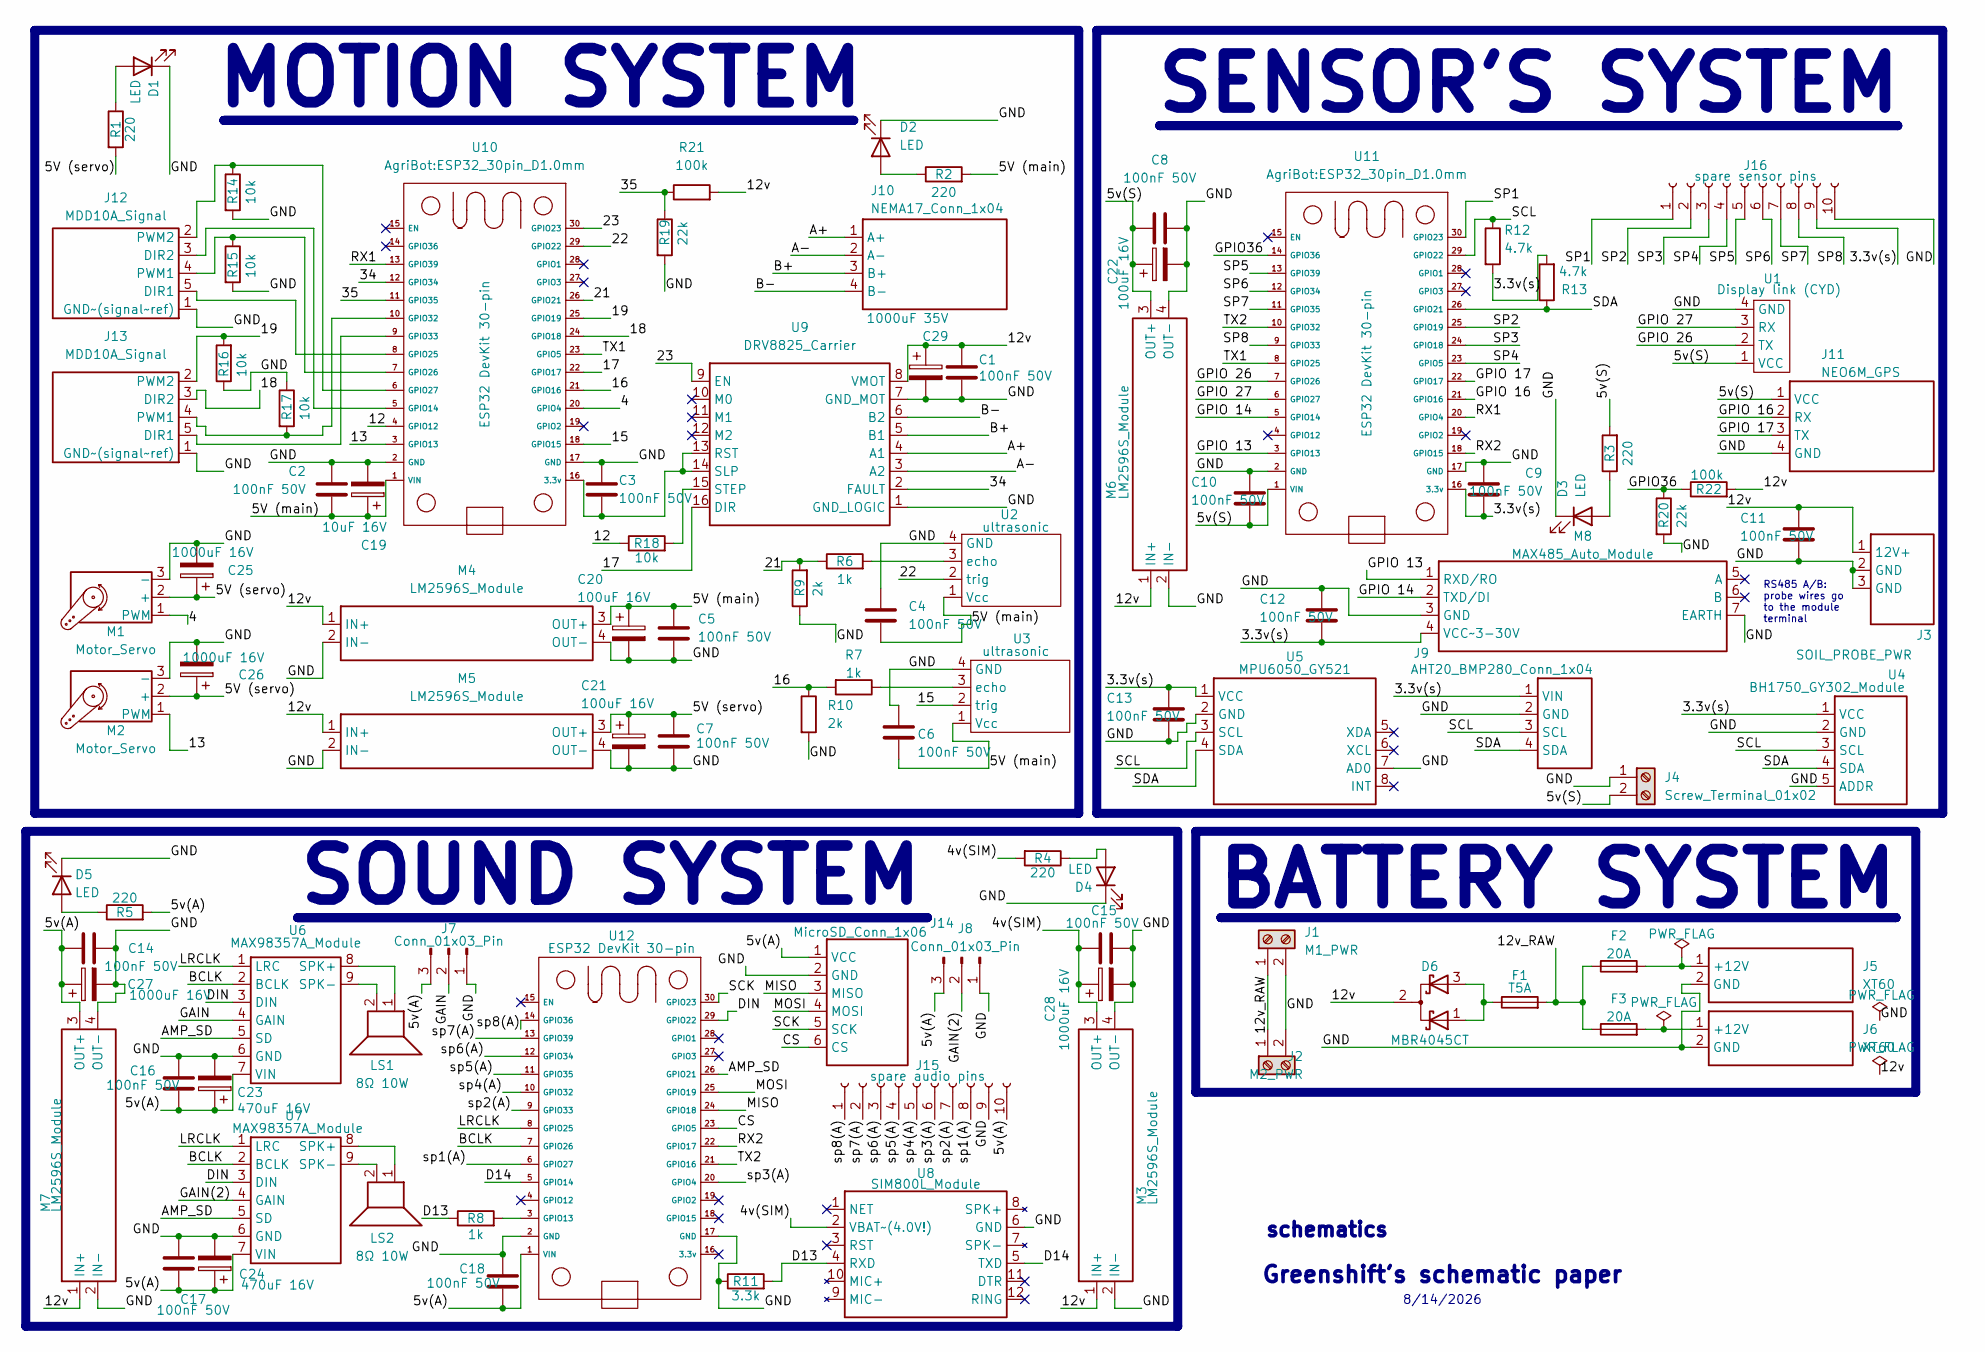
[picture p16: schematic agribot.kicad_sch]

Parts:
C1, C2, C3, C4, C5, C6, C7, C8, C9, C10, C11, C12, C13, C14, C15, C16, C17, C18: 100nF 50V; C_Disc_D5.0mm_W2.5mm_P5.00mm
C19: 10uF 16V; CP_Radial_D5.0mm_P2.00mm
C20, C21, C22: 100uF 16V; CP_Radial_D6.3mm_P2.50mm
C23, C24: 470uF 16V; CP_Radial_D10.0mm_P5.00mm
C25, C26, C27, C28: 1000uF 16V; CP_Radial_D10.0mm_P5.00mm
C29: 1000uF 35V; CP_Radial_D13.0mm_P5.00mm
D1, D2, D3, D4, D5: LED; LED_D5.0mm
D6: MBR4045CT; TO-220-3_Vertical
F1: T5A; Fuseholder_Clip-5x20mm_Littelfuse_111_Inline_P20.00x5.00mm_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
F2, F3: 20A; Fuseholder_Clip-5x20mm_Littelfuse_100_Inline_P20.50x4.60mm_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
J1: M1_PWR; KF128-7.5_1x02_P7.50mm_Horizontal
J2: M2_PWR; KF128-7.5_1x02_P7.50mm_Horizontal
J3: SOIL_PROBE_PWR; TerminalBlock_Phoenix_MKDS-1,5-3-5.08_1x03_P5.08mm_Horizont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
J4: Screw_Terminal_01x02; TerminalBlock_Phoenix_MKDS-1,5-2-5.08_1x02_P5.08mm_Horizont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
J5, J6: XT60; AMASS_XT60-M_1x02_P7.20mm_Vertical
J7, J8: Conn_01x03_Pin; PinHeader_1x03_P2.54mm_Vertical
J9: AHT20_BMP280_Conn_1x04; JST_XH_B4B-XH-A_1x04_P2.50mm_Vertical
J10: NEMA17_Conn_1x04; JST_XH_B4B-XH-A_1x04_P2.50mm_Vertical
J11: NEO6M_GPS; JST_XH_B4B-XH-A_1x04_P2.50mm_Vertical
J12, J13: MDD10A_Signal; JST_XH_B5B-XH-A_1x05_P2.50mm_Vertical
J14: MicroSD_Conn_1x06; PinSocket_1x06_P2.54mm_Vertical
J15: spare audio pins; PinSocket_2x05_P2.54mm_Vertical
J16: spare sensor pins; PinSocket_2x05_P2.54mm_Vertical
LS1, LS2: 8Ω 10W
M1, M2: Motor_Servo; PinHeader_1x03_P2.54mm_Vertical
M3, M4, M5, M6, M7: LM2596S_Module; LM2596S_Module_FlatMount_SMD
M8: MAX485_Auto_Module; JST_XH_B4B-XH-A_1x04_P2.50mm_Vertical
R1, R2, R3, R4, R5: 220; R_Axial_DIN0207_L6.3mm_D2.5mm_P10.16mm_Horizontal
R6, R7, R8: 1k; R_Axial_DIN0207_L6.3mm_D2.5mm_P10.16mm_Horizontal
R9, R10: 2k; R_Axial_DIN0207_L6.3mm_D2.5mm_P10.16mm_Horizontal
R11: 3.3k; R_Axial_DIN0207_L6.3mm_D2.5mm_P10.16mm_Horizontal
R12, R13: 4.7k; R_Axial_DIN0207_L6.3mm_D2.5mm_P10.16mm_Horizontal
R14, R15, R16, R17, R18: 10k; R_Axial_DIN0207_L6.3mm_D2.5mm_P10.16mm_Horizontal
R19, R20: 22k; R_Axial_DIN0207_L6.3mm_D2.5mm_P10.16mm_Horizontal
R21, R22: 100k; R_Axial_DIN0207_L6.3mm_D2.5mm_P10.16mm_Horizontal
U1: Display link (CYD); JST_XH_B4B-XH-A_1x04_P2.50mm_Vertical
U2, U3: ultrasonic; JST_XH_B4B-XH-A_1x04_P2.50mm_Vertical
U4: BH1750_GY302_Module; JST_XH_B5B-XH-A_1x05_P2.50mm_Vertical
U5: MPU6050_GY521; PinSocket_1x08_P2.54mm_Vertical
U6, U7: MAX98357A_Module; PinSocket_1x07_P2.54mm_Vertical
U8: SIM800L_Module
U9: DRV8825_Carrier; Pololu_Breakout-16_15.2x20.3mm_D1.0mm
U10, U11, U12: ESP32 DevKit 30-pin; ESP32_30pin_D1.0mm

Connections:
/3.3v(s): C9.2, C12.2, C13.1, J9.1 (VIN), J16.9, M8.4 (VCC~3-30V), R12.2, R13.2, U4.1 (VCC), U5.1 (VCC), U11.16 (3.3v)
/4: M1.1 (PWM), U10.20 (GPIO4)
/4v(SIM): C15.2, C28.1, M3.3 (OUT+), R4.2, U8.2 (VBAT~(4.0V!))
/5V (main): C2.2, C4.2, C5.1, C6.2, C19.1, C20.1, M4.3 (OUT+), R2.2, U2.1 (Vcc), U3.1 (Vcc), U10.1 (VIN)
/5V (servo): C7.1, C21.1, C25.1, C26.1, M1.2 (+), M2.2 (+), M5.3 (OUT+), R1.2
/5v(A): C14.2, C16.1, C17.1, C18.2, C23.1, C24.1, C27.1, J7.3, J8.3, J14.1 (VCC), J15.10, M7.3 (OUT+), R5.2, U6.7 (VIN), U7.7 (VIN), U12.1 (VIN)
/5v(S): C8.1, C10.2, C22.1, J4.2, J11.1 (VCC), M6.3 (OUT+), R3.2, U1.1 (VCC), U11.1 (VIN)
/12: R18.1, U10.4 (GPIO12)
/12v: C1.1, C11.1, C29.1, D6.2 (K), J3.1 (12V+), M3.1 (IN+), M4.1 (IN+), M5.1 (IN+), M6.1 (IN+), M7.1 (IN+), R21.2, R22.2, U9.8 (VMOT)
/12v_RAW: F1.2, F2.1, F3.1, J1.1, J2.1
/13: M2.1 (PWM), U10.3 (GPIO13)
/15: U3.2 (trig), U10.18 (GPIO15)
/16: R7.2, R10.1, U10.21 (GPIO16)
/17: U9.16 (DIR), U10.22 (GPIO17)
/18: J13.3 (DIR2), U10.24 (GPIO18)
/19: J13.2 (PWM2), R16.2, U10.25 (GPIO19)
/21: R6.1, R9.2, U10.26 (GPIO21)
/22: U2.2 (trig), U10.29 (GPIO22)
/23: U9.9 (EN), U10.30 (GPIO23)
/34: U9.2 (FAULT), U10.12 (GPIO34)
/35: R19.1, R21.1, U10.11 (GPIO35)
/A+: J10.1 (A+), U9.4 (A1)
/A-: J10.2 (A-), U9.3 (A2)
/AMP_SD: U6.5 (SD), U7.5 (SD), U12.26 (GPIO21)
/B+: J10.3 (B+), U9.5 (B1)
/B-: J10.4 (B-), U9.6 (B2)
/BCLK: U6.2 (BCLK), U7.2 (BCLK), U12.7 (GPIO26)
/CS: J14.6 (CS), U12.23 (GPIO5)
/D13: R8.1, R11.2, U8.4 (RXD)
/D14: U8.5 (TXD), U12.5 (GPIO14)
/DIN: U6.3 (DIN), U7.3 (DIN), U12.29 (GPIO22)
/GAIN: J7.2, U6.4 (GAIN)
/GAIN(2): J8.2, U7.4 (GAIN)
/GND: C1.2, C2.1, C3.1, C4.1, C5.2, C6.1, C7.2, C8.2, C9.1, C10.1, C11.2, C12.1, C13.2, C14.1, C15.1, C16.2, C17.2, C18.1, C19.2, C20.2, C21.2, C22.2, C23.2, C24.2, C25.2, C26.2, C27.2, C28.2, C29.2, D1.1 (K), D2.1 (K), D3.1 (K), D4.1 (K), D5.1 (K), J1.2, J2.2, J3.2 (GND), J3.3 (GND), J4.1, J5.2 (GND), J6.2 (GND), J7.1, J8.1, J9.2 (GND), J11.4 (GND), J12.1 (GND~(signal~ref)), J13.1 (GND~(signal~ref)), J14.2 (GND), J15.9, J16.10, M1.3 (-), M2.3 (-), M3.2 (IN-), M3.4 (OUT-), M4.2 (IN-), M4.4 (OUT-), M5.2 (IN-), M5.4 (OUT-), M6.2 (IN-), M6.4 (OUT-), M7.2 (IN-), M7.4 (OUT-), M8.3 (GND), M8.7 (EARTH), R9.1, R10.2, R11.1, R14.2, R15.2, R16.1, R17.1, R19.2, R20.2, U1.4 (GND), U2.4 (GND), U3.4 (GND), U4.2 (GND), U4.5 (ADDR), U5.2 (GND), U5.7 (AD0), U6.6 (GND), U7.6 (GND), U8.6 (GND), U9.1 (GND_LOGIC), U9.7 (GND_MOT), U10.2 (GND), U10.17 (GND), U11.2 (GND), U11.17 (GND), U12.2 (GND), U12.17 (GND)
/GPIO36: R20.1, R22.1, U11.14 (GPIO36)
/GPIO 13: M8.1 (RXD/RO), U11.3 (GPIO13)
/GPIO 14: M8.2 (TXD/DI), U11.5 (GPIO14)
/GPIO 16: J11.2 (RX), U11.21 (GPIO16)
/GPIO 17: J11.3 (TX), U11.22 (GPIO17)
/GPIO 26: U1.2 (TX), U11.7 (GPIO26)
/GPIO 27: U1.3 (RX), U11.6 (GPIO27)
/LRCLK: U6.1 (LRC), U7.1 (LRC), U12.8 (GPIO25)
/MISO: J14.3 (MISO), U12.24 (GPIO18)
/MOSI: J14.4 (MOSI), U12.25 (GPIO19)
/RX1: U10.13 (GPIO39), U11.20 (GPIO4)
/RX2: U11.18 (GPIO15), U12.22 (GPIO17)
/SCK: J14.5 (SCK), U12.30 (GPIO23)
/SCL: J9.3 (SCL), R12.1, U4.3 (SCL), U5.3 (SCL), U11.29 (GPIO22)
/SDA: J9.4 (SDA), R13.1, U4.4 (SDA), U5.4 (SDA), U11.26 (GPIO21)
/SP1: J16.1, U11.30 (GPIO23)
/SP2: J16.2, U11.25 (GPIO19)
/SP3: J16.3, U11.24 (GPIO18)
/SP4: J16.4, U11.23 (GPIO5)
/SP5: J16.5, U11.13 (GPIO39)
/SP6: J16.6, U11.12 (GPIO34)
/SP7: J16.7, U11.11 (GPIO35)
/SP8: J16.8, U11.9 (GPIO33)
/TX1: U10.23 (GPIO5), U11.8 (GPIO25)
/TX2: U11.10 (GPIO32), U12.21 (GPIO16)
/sp1(A): J15.8, U12.6 (GPIO27)
/sp2(A): J15.7, U12.9 (GPIO33)
/sp3(A): J15.6, U12.20 (GPIO4)
/sp4(A): J15.5, U12.10 (GPIO32)
/sp5(A): J15.4, U12.11 (GPIO35)
/sp6(A): J15.3, U12.12 (GPIO34)
/sp7(A): J15.2, U12.13 (GPIO39)
/sp8(A): J15.1, U12.14 (GPIO36)
unnamed: D1.2 (A), R1.1
unnamed: D2.2 (A), R2.1
unnamed: D3.2 (A), R3.1
unnamed: D4.2 (A), R4.1
unnamed: D5.2 (A), R5.1
unnamed: D6.1 (A), D6.3 (A), F1.1
unnamed: F2.2, J5.1 (+12V)
unnamed: F3.2, J6.1 (+12V)
unnamed: J12.5 (DIR1), U10.8 (GPIO25)
unnamed: J12.3 (DIR2), U10.5 (GPIO14)
unnamed: J12.4 (PWM1), R15.1, U10.7 (GPIO26)
unnamed: J12.2 (PWM2), R14.1, U10.6 (GPIO27)
unnamed: J13.5 (DIR1), U10.9 (GPIO33)
unnamed: J13.4 (PWM1), R17.2, U10.10 (GPIO32)
unnamed: LS1.1, U6.8 (SPK+)
unnamed: LS1.2, U6.9 (SPK-)
unnamed: LS2.1, U7.8 (SPK+)
unnamed: LS2.2, U7.9 (SPK-)
unnamed: R6.2, U2.3 (echo)
unnamed: R7.1, U3.3 (echo)
unnamed: R18.2, U9.15 (STEP)
unnamed: C3.2, U9.13 (RST), U9.14 (SLP), U10.16 (3.3v)
unnamed: R8.2, U12.3 (GPIO13)

Notes on the sheet:
BATTERY SYSTEM
Greenshift's schematic paper
schematics
SOUND SYSTEM
RS485 A/B: probe wires go to the module terminal
MOTION SYSTEM
8/14/2026
SENSOR'S SYSTEM

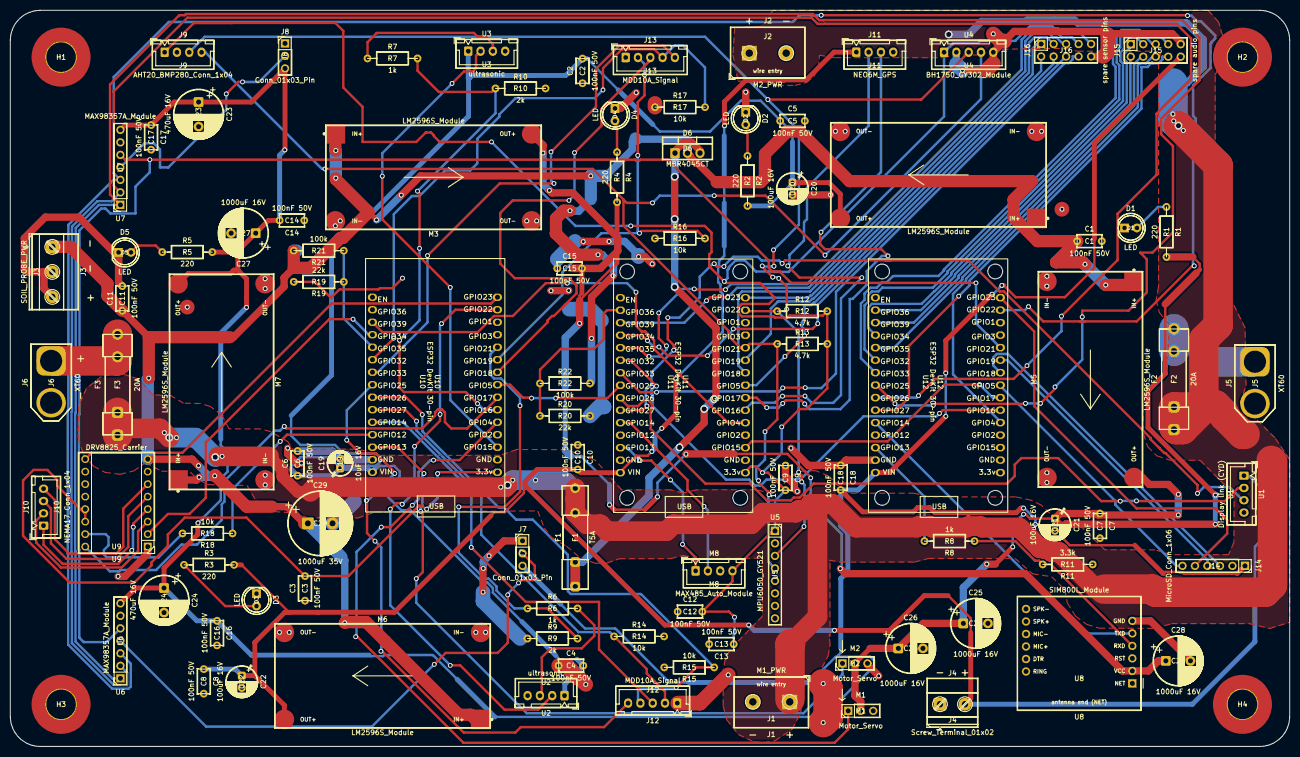
[picture p17: board agribot.kicad_pcb from above]

Board: 2 copper layers, 260.0 x 149.6 mm, 100 parts (0 on the bottom side), 86 nets.

Other parts of the board:
H1, H2, H3, H4: MountingHole_6mm_Pad_TopBottom
