Maleksameh61/Agribot/(commit log)

2026-10-17 Initialize README with project details for AgriBot
    Added detailed project description, usage instructions, and specifications for AgriBot, including hardware components and wiring.
2026-10-17 Link module footprints to 3D models
2026-10-17 Add 3D render, full schematic and wiring diagram
2026-10-17 Add Gerbers + drill files and schematic PDF
2026-10-17 Board: refilled zones, 3D models linked for all modules
    [agribot.kicad_pcb]
2026-10-17 Add STEP of the full assembled board (zipped, 24 MB raw)
2026-10-17 Local Egypt BOM (EGP + USD with shipping), README: wiring, KiCanvas link, files list
    [BOM.csv]
2026-10-17 Add KiCad and OS temporary files to .gitignore
2026-10-18 Add full rover assembly (STEP + Fusion F3D)
    [agribot-rover.f3d, agribot-rover.step]
2026-10-18 Add rover assembly render
2026-10-18 README: add the whole rover section and CAD files
2026-10-18 Rover assembly with the main board mounted inside (STEP, zipped)
2026-10-18 Rover renders: outside and inside with the board
2026-10-18 README: show the board inside the rover
2026-10-18 Update rover F3D with latest Fusion edits
    [agribot-rover.f3d]
2026-10-18 README: drop the rover CAD section
2026-10-18 Point the board at the new module models, add socket models
    [agribot.kicad_pcb]
2026-10-18 Footprints use the new stpZ models + KiCad sockets
2026-10-18 Re-export board STEP with the real module models
2026-10-18 EasyEDA source models for fuse clips, fuse and KF128 (Source: JLCEDA/EasyEDA Official Library)
2026-10-18 Fuse and KF128 terminal 3D models (Source: JLCEDA/EasyEDA Official Library) + credits
2026-10-18 Board: fuses and KF128 terminals use the new 3D models
    [agribot.kicad_pcb]
2026-10-18 Fuse clip and KF128 footprints point at the new models
2026-10-18 Re-export board STEP with fuses and KF128 terminals
2026-10-18 New 3D render with fuses and terminal blocks
2026-10-18 README: model credits; BOM: price for jumper caps
    [BOM.csv]
2026-10-18 Board: moved M2_PWR, reroute, zones refilled
    [agribot.kicad_pcb]
2026-10-18 Re-plot gerbers and drill files from the current board
2026-10-18 Re-export board STEP from the current board
2026-10-18 Fresh 3D and PCB renders of the current board
2026-10-19 LM2596 footprint fix: correct pin order + pitch, rerouted
    [agribot.kicad_pcb]
2026-10-19 LM2596 footprint: pin order from module silkscreen, 4mm pads cover clone pitch range
2026-10-19 Regenerate gerbers + drill after LM2596 fix
2026-10-19 Update board renders after LM2596 fix
2026-10-19 Board cleanup: remove dangling stubs, name mounting holes H1-H4, move SIM800L note off silkscreen
    [agribot.kicad_pcb]
2026-10-19 Re-plot gerbers + drill after board cleanup
2026-10-19 PCB renders after board cleanup
2026-10-20 Add +/- polarity marks next to J4 (ESP32-CAM 5V terminal)
    J4's pin 1 is GND, while J1-J3 have + on pin 1, and nothing on the
    board said which side was which. Silkscreen only, no copper change.
    [agribot.kicad_pcb]
2026-10-20 BOM: put USD unit/total prices and links first, EGP after
    Same rows, same numbers (total 140.71 USD), just reordered so the USD
    pricing is the first thing you see. Filled in the missing unit price
    on the PCB fab line (45 USD / 5 boards).
    [BOM.csv]
2026-10-20 New off-board wiring diagram
    Board map with every cable plug numbered at its real position, then a
    pin-to-pin harness for each group (power and drive, Motion, Sensors,
    audio and camera) with wire colours and gauges. Pinouts taken from the
    board file and the firmware pin maps.
2026-10-20 Rewrite README: autonomous mode first, why I made it, current images
2026-10-20 README: lead with what it does, add the LM2596 story and the probe question
2026-11-03 Unzip STEP, add top-level production folder (gerbers, schematic, firmware copy)
    [agribot-pcb.step]
2026-11-03 BOM: label as bare PCB build, add Location column
    [BOM.csv]
2026-11-03 BOM: replace PCB fab and JLC shipping estimates with a real quote
    [BOM.csv]
2026-11-03 README: update costs, Files section and schematic link
2026-11-03 Add full rover assembly STEP
    [agribot-full-assembly.step]
2026-11-03 Add firmware for all 5 boards
    Sensors (hub, WiFi + phone page, missions, logging), Motion, Audio,
    CYD display and ESP32-CAM, plus the shared UART protocol.
2026-11-03 Rename BOM.csv to AgriBot_PCB_Cost.csv, add whole rover cost sheet
    [AgriBot_Entire_Project_Cost.xlsx, AgriBot_PCB_Cost.csv]
2026-11-03 Move cost files into BOM folder
    [AgriBot_Entire_Project_Cost.xlsx, AgriBot_PCB_Cost.csv]
2026-11-03 Add full assembly STEP to README
2026-11-03 Rename PCB BOM back to BOM.csv, add full rover render to README
    [BOM.csv]
2026-11-06 Add printable parts as STEP: motor mounts + ESP32-CAM pan/tilt
    [motor-mount-1.step, motor-mount-2.step, motor-mount-3.step, motor-mount-4.step, pan-tilt-cam-back-cover.step, pan-tilt-cam-case-with-tilt-support.step, pan-tilt-tilt-plate.step, pan-tilt-yaw-base.step]
2026-11-06 Clean up docs: printables README, AI note, microSD model credit
2026-11-06 Narrow reviewer note to the PCB files
2026-11-06 List printables in README with pan/tilt credit
2026-11-06 Keep pan/tilt credit in printables README only
2026-11-07 Update README with component details and setup instructions
    Clarify details about components and assembly instructions.
2026-11-07 Add AgriBot_PCB_Cost.csv file
    [AgriBot_PCB_Cost.csv]
2026-11-08 Add AliExpress links to both BOMs
    [AgriBot_Entire_Project_Cost.xlsx, AgriBot_PCB_Cost.csv]
